RicardoScarvalho/-Robota-Segue-Linha/Barry/pcb-seguidor-2024-alison/README.md

# pcb-seguidor-2024
Desenvolvimento da pcb do robô seguidor de linha 2024 usando kicad
