RicardoScarvalho/-Robota-Segue-Linha/Sally/lista de componentes.xlsx

N° | Compoentens | Descrição | Quantidade | Link | Preço | Frete
2 | Ponte H | TB6612FNG | 1 | TB6612FNG (https://www.aliexpress.com/item/1005008526016974.html?src=google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) | 28.51 | 0
3 | Motor | Coreless eixo duplo 18000rpm | 1 | Link do motor (https://pt.aliexpress.com/item/1005001977190908.html?src=google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) | 35.69 | 0
4 | Bateria | Darwin FPV 3 Cells 60c 380mAh | 2 | https://pt.aliexpress.com/item/1005006702761223.html
5 | Sensor lateral | 10 sensores QRE1113 | 2 | link sensores (https://pt.aliexpress.com/item/1005005562914257.html?src=google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) | 18.2 | 0
6 | Mux | CD74HC4067M CI | 1 | link mux (https://www.mercadolivre.com.br/ci-hc4067--74hc4067-m--smd/up/MLBU3162970750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) | 18.57 | 7.99
8 | Buzzer | Buzzer HXD | 1 | https://www.eletrogate.com/buzzer-ativo-12v
9 | Botões | Botões: push button | 4 | https://www.eletrogate.com/push-button-chave-tactil-6x6x6mm
10 | Leds | LED 1206 3216 | 6 | https://www.acheicomponentes.com.br/led/kit-10-pecas-led-smd-amarelo-1206-3216-17-21w1d-apqhy3t
11 | Tripot | Tripot BC547 | 2 | https://www.eletrogate.com/transistor-npn-bc547
12 | Ampop | Opamp lm741 | 2 | https://www.makerhero.com/produto/lm741-ci-amplificador-operacional/
13 | Capacitor | 100nF | 2 | https://www.eletrogate.com/capacitor-poliester-metalizado-100nf-x-400v
14 | Capacitor polarizado | 47uF | 1 | https://www.eletrogate.com/capacitor-eletrolitico-47uf-x-50v
15 | ESD | TPD4E02B04DQA | 1 | https://pt.aliexpress.com/item/1005006614319754.html?gatewayAdapt=glo2bra
16 | USB Type C | USB_C_Receptacle_USB2.0_16P | 1 | https://www.proesi.com.br/conector-usb-c-femea-90-smd-16-pinos-11x7mm
17 | Resitor | 1M ohm (substituível por 100k ohm) | 1 | https://www.eletrogate.com/resistor-1m-1-4w-10-unidades?gad_source=1&gad_campaignid=20223015315
18 | Resitor | 15 ohm | 4 | https://www.proesi.com.br/resistor-carbono-cr25-1-4w-15r
19 | Resitor | 10k ohm | 10 | https://www.eletrogate.com/resistor-10k-1-4w-10-unidades?gad_source=1&gad_campaignid=20223015315
22 | Resitor | 220 ohm | 7 | https://www.eletrogate.com/resistor-220r-1-4w-10-unidades?gad_source=1&gad_campaignid=20223015315
23 | Resitor | 5k1 ohm | 2 | https://www.eletrogate.com/resistor-5k1-1-4w-10-unidades?gad_source=1&gad_campaignid=20223015315
24 | Resitor | 22 ohm | 2 | https://www.eletrogate.com/resistor-22r-1-4w-10-unidades?gad_source=1&gad_campaignid=20223015315
25 | Cabo | Cabo Flat de 8 vias | 1 | https://produto.mercadolivre.com.br/MLB-4589422190-cabo-flat-flex-8-vias-8-95-10-11-12-15-20-25-30-42cm-_JM
 | Cabo | Cabo Flat de 4 vias | 1
26 | Sensor frontal | Módulo Seguidor de Linha Infravermelho - 8 Canais | 1 | https://www.eletrogate.com/modulo-seguidor-de-linha-infravermelho-8-canais
