RicardoScarvalho/-Robota-Segue-Linha/Sally/3D/Montagem1.SLDASM

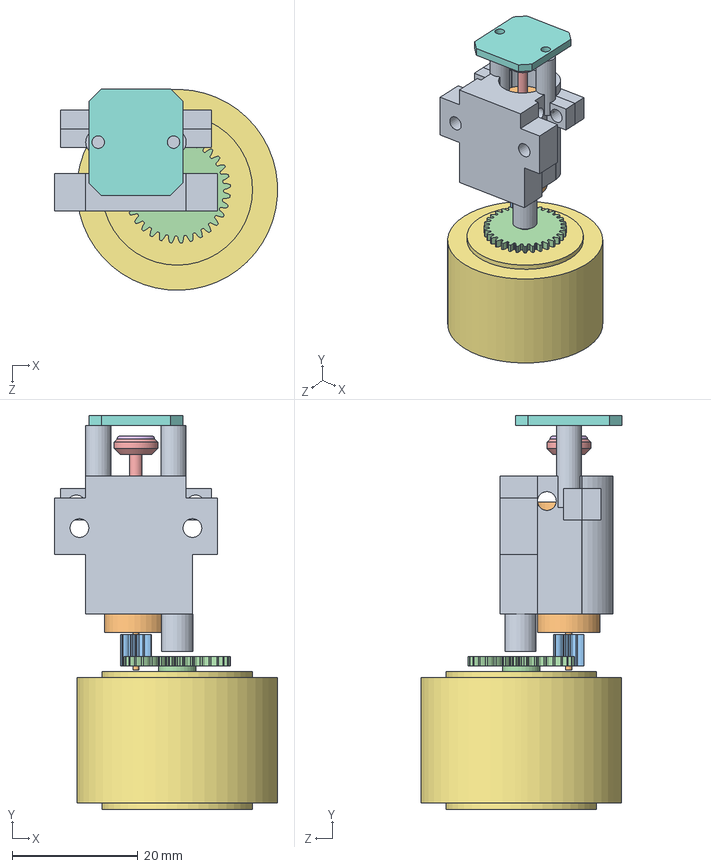
[picture p4: CAD file, 2026-09-08]
Sally/3D/Montagem1.SLDASM
35.6 x 62.8 x 32.1 mm
suporte2
motor
Engrenagem 0.5 8T-
Engrenagem 0.5 32T
suporteima
ima
roda
encoder
suporte4
