RicardoScarvalho/-Robota-Segue-Linha/Sally/3D/Montagem2.SLDASM

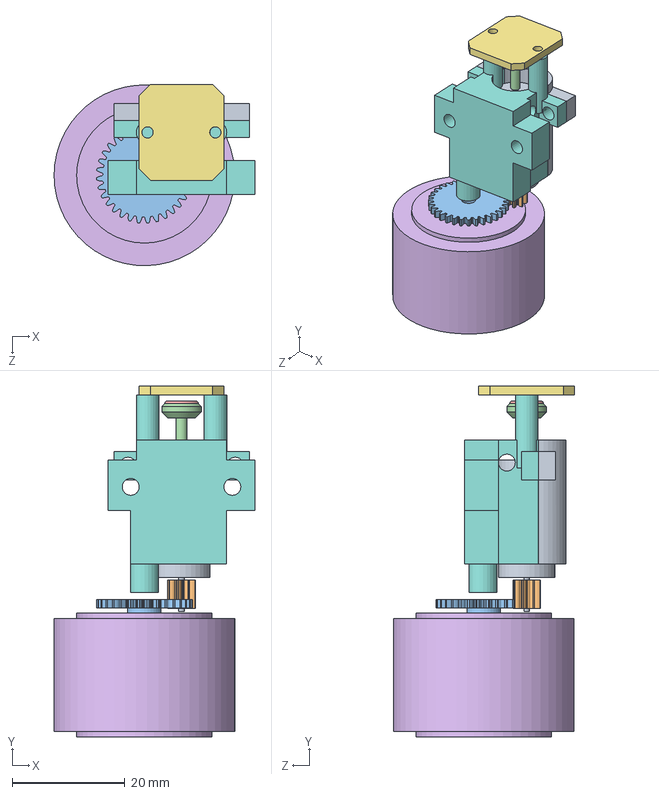
[picture p5: CAD file, 2026-09-08]
Sally/3D/Montagem2.SLDASM
35.6 x 62.2 x 32.1 mm
motor
Engrenagem 0.5 8T-
Engrenagem 0.5 32T
suporteima
ima
roda
encoder
suporte3
suporte4
