RicardoScarvalho/-Robota-Segue-Linha/Sally/3D/Montagem13.SLDASM

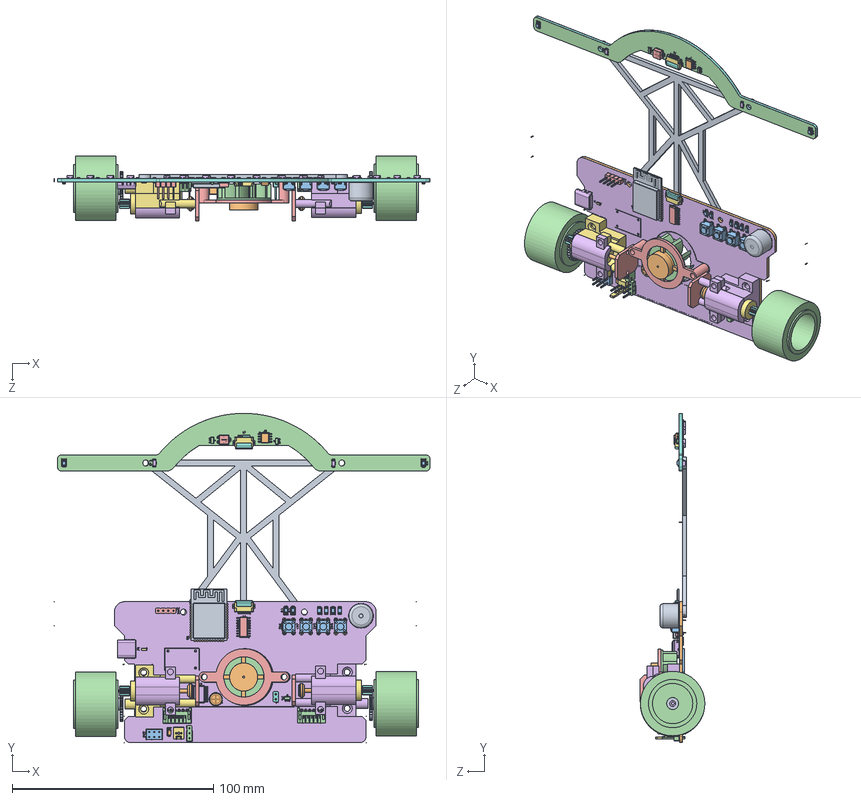
[picture p6: CAD file, 2026-09-08]
Sally/3D/Montagem13.SLDASM
186.8 x 163.6 x 32.1 mm
suporte
suportemotor - Part 2
suportesaia
ventoinha10pas
Peça97
R_1206_3216Metric x 45
lock x 2
pins x 2
SOIC-8_3.9x4.9mm_P1.27mm
LED_1206_3216Metric x 8
SOT-23 x 3
Potentiometer_Bourns_3314G_Vertical
OnSemi_CASE100CY x 16
sensor_frontal_copper
sensor_frontal_pad
sensor_frontal_via
sensor_frontal_silkscreen
sensor_frontal_silkscreen_2
sensor_frontal_soldermask
sensor_frontal_soldermask_2
sensor_frontal_PCB_1
sensor_frontal_PCB_2
sensor_frontal_PCB_3
ESP32-S3-WROOM-1
D_SOD-123
SW_PUSH_6mm x 4
PinHeader_1x03_P254mm_Vertical
SOIC-16_3.9x9.9mm_P1.27mm
SSOP-24_5.3x8.2mm_P0.65mm
USON_10_25x10mm_Pitch05mm
PinHeader_1x02_P254mm_Vertical
Buzzer_12x95RM76
CP_Radial_D63mm_P250mm
PinHeader_2x03_P254mm_Vertical
JST_S6B_PH_K x 2
PinHeader_1x04_P254mm_Vertical
USB_C_Receptacle_GCT_USB4085
Molex_AE_6410_02A
C_0805_2012Metric x 2
sally_copper
sally_pad
sally_via
sally_silkscreen
sally_silkscreen_2
sally_soldermask
sally_soldermask_2
sally_PCB_1
sally_PCB_2
sally_PCB_3
sally_PCB_4
sally_PCB_5
sally_PCB_6
sally_PCB_7
sally_PCB_8
sally_PCB_9
sally_PCB_10
sally_PCB_11
sally_PCB_12
sally_PCB_13
sally_PCB_14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
