RicardoScarvalho/-Robota-Segue-Linha/Sally/3D/Sistema de Sucção/suportemotor - Part 2.step

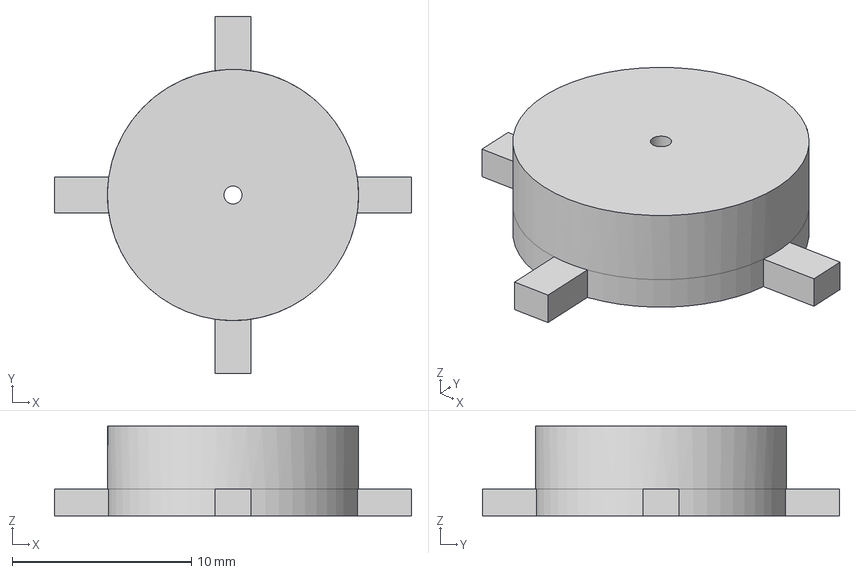
[picture p7: CAD file, 2026-09-08]
Sally/3D/Sistema de Sucção/suportemotor - Part 2.step
19.9 x 19.9 x 5.00 mm
