RicardoScarvalho/-Robota-Segue-Linha/Sally/3D/Sistema de Sucção/suportemotor.stl

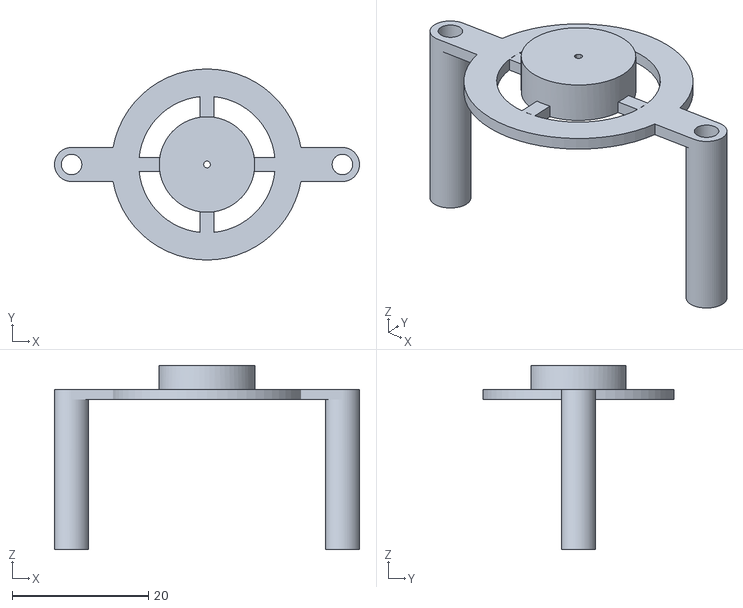
[picture p8: CAD file, 2026-09-08]
Sally/3D/Sistema de Sucção/suportemotor.stl
44.7 x 28.0 x 27.0
