RicardoScarvalho/-Robota-Segue-Linha/Sally/3D/Sistema de Sucção/Peça2.DXF

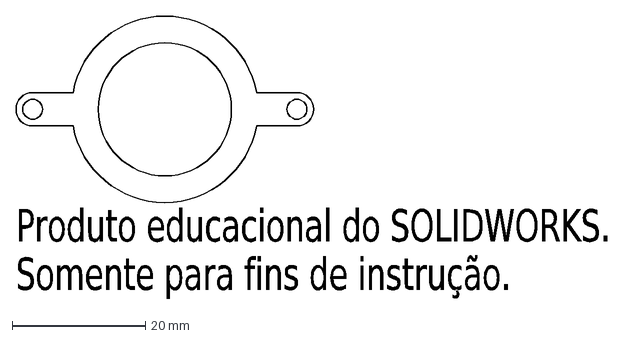
[picture p9: CAD file, 2026-09-08]
Sally/3D/Sistema de Sucção/Peça2.DXF
Produto educacional do SOLIDWORKS.
Somente para fins de instrução.
