RicardoScarvalho/-Robota-Segue-Linha/Sally/3D/Sistema de Sucção/Peça97.SLDPRT

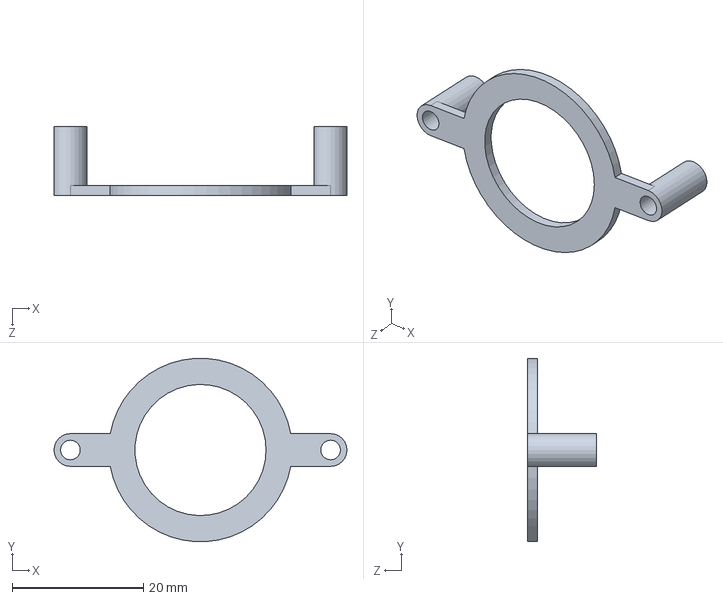
[picture p10: CAD file, 2026-09-08]
Sally/3D/Sistema de Sucção/Peça97.SLDPRT
44.7 x 27.9 x 10.5 mm
