RicardoScarvalho/-Robota-Segue-Linha/Sally/3D/ima.SLDPRT

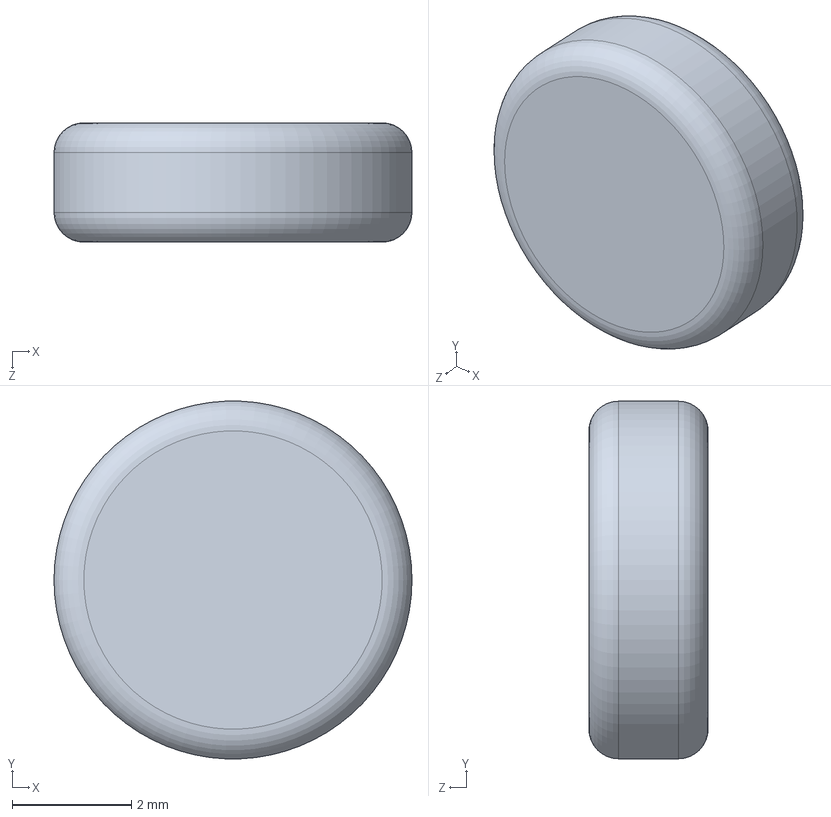
[picture p11: CAD file, 2026-09-08]
Sally/3D/ima.SLDPRT
6.00 x 5.99 x 2.00 mm
