RicardoScarvalho/-Robota-Segue-Linha/Sally/3D/Sistema de Sucção/suportemotor - Part 1.sldprt

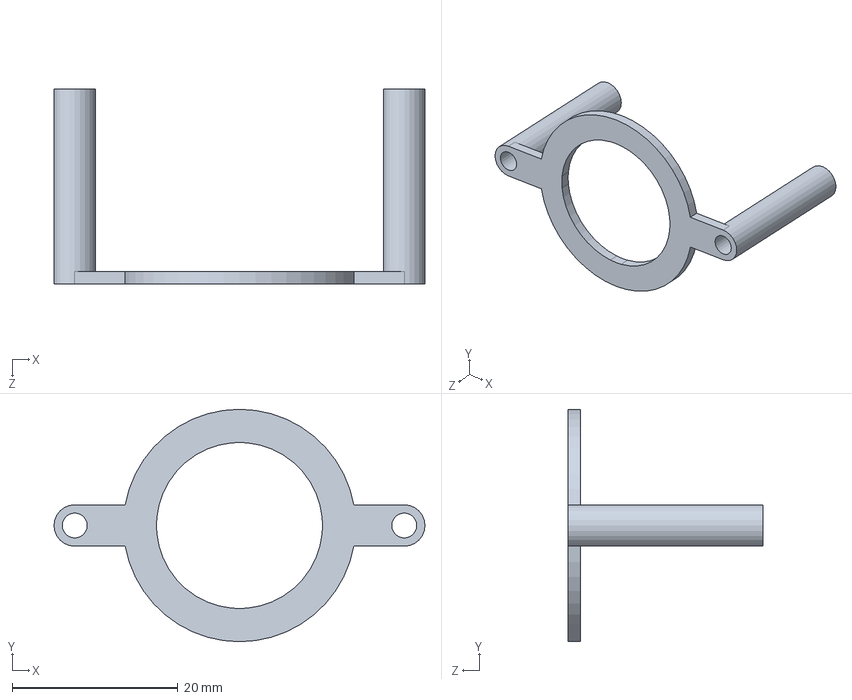
[picture p12: CAD file, 2026-09-08]
Sally/3D/Sistema de Sucção/suportemotor - Part 1.sldprt
44.7 x 28.0 x 23.5 mm
