RicardoScarvalho/-Robota-Segue-Linha/Sally/3D/Sistema de Sucção/ventoinha10pas.step

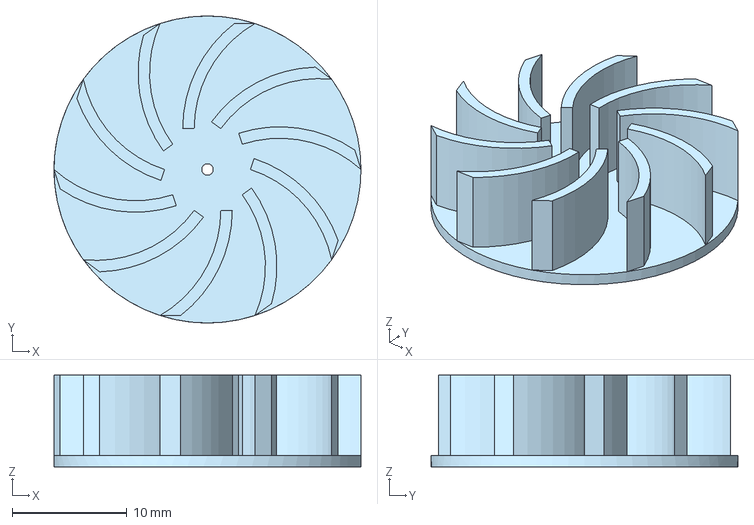
[picture p13: CAD file, 2026-09-08]
Sally/3D/Sistema de Sucção/ventoinha10pas.step
26.7 x 26.7 x 8.00 mm
