RicardoScarvalho/-Robota-Segue-Linha/Sally/3D/suporte4.SLDPRT

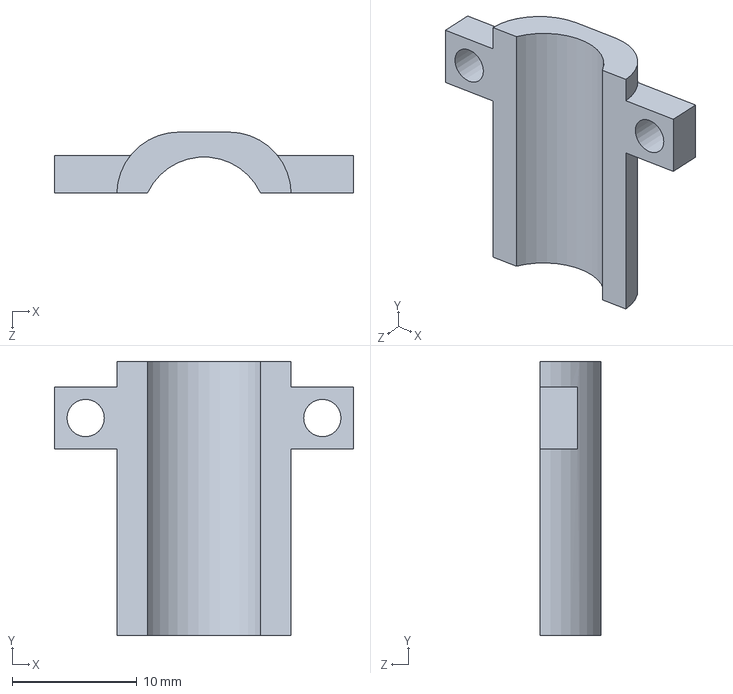
[picture p14: CAD file, 2026-09-08]
Sally/3D/suporte4.SLDPRT
24.0 x 22.0 x 4.88 mm
