RicardoScarvalho/-Robota-Segue-Linha/Sally/3D/Sistema de Sucção/suportesaia.step

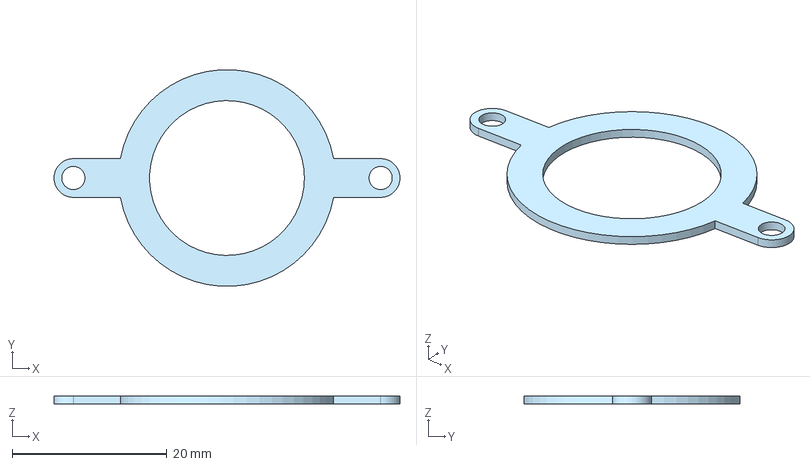
[picture p15: CAD file, 2026-09-08]
Sally/3D/Sistema de Sucção/suportesaia.step
44.7 x 27.9 x 1.00 mm
