RicardoScarvalho/-Robota-Segue-Linha/Sally/3D/Engrenagem 0.5 32T.SLDPRT

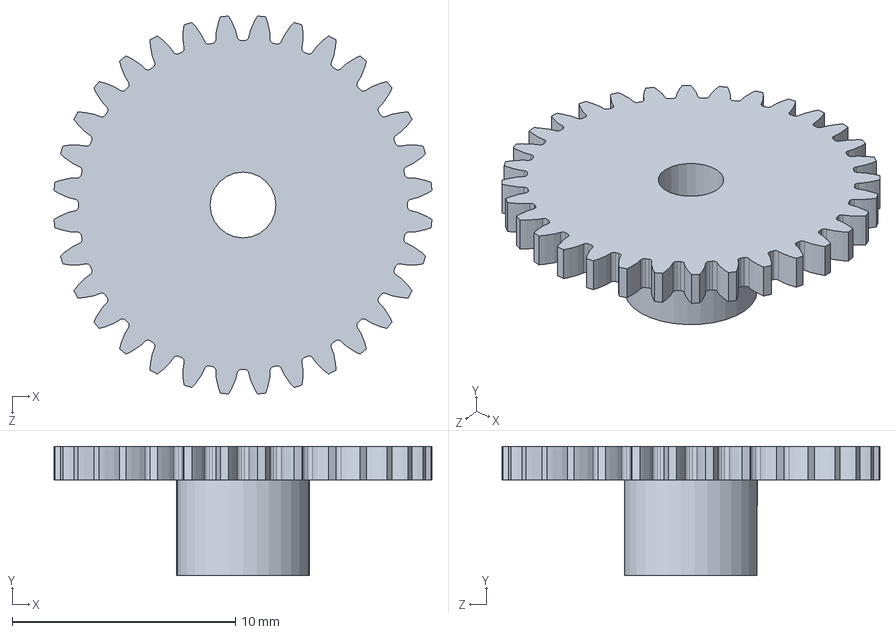
[picture p16: CAD file, 2026-09-08]
Sally/3D/Engrenagem 0.5 32T.SLDPRT
17.0 x 5.80 x 17.0 mm
