RicardoScarvalho/-Robota-Segue-Linha/Sally/3D/Engrenagem 0.5 8T-.SLDPRT

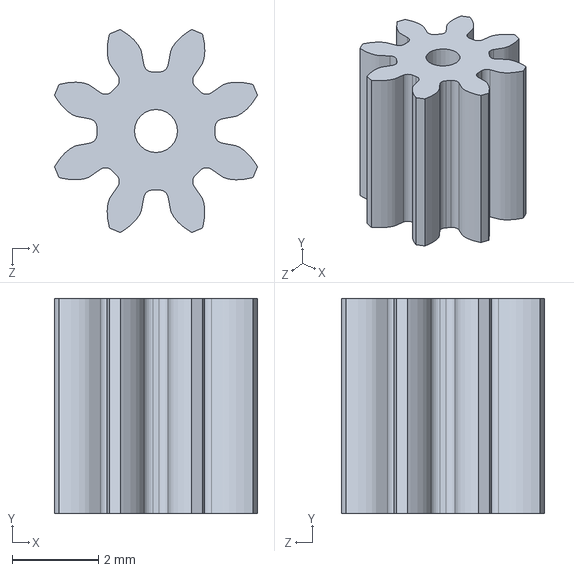
[picture p17: CAD file, 2026-09-08]
Sally/3D/Engrenagem 0.5 8T-.SLDPRT
4.72 x 5.00 x 4.72 mm
