RicardoScarvalho/-Robota-Segue-Linha/Sally/3D/suporte2.SLDPRT

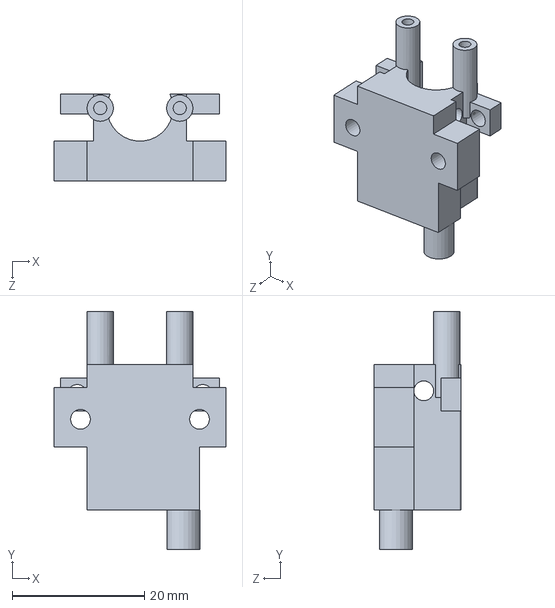
[picture p18: CAD file, 2026-09-08]
Sally/3D/suporte2.SLDPRT
26.0 x 36.0 x 13.1 mm
