RicardoScarvalho/-Robota-Segue-Linha/Sally/3D/encoder.SLDPRT

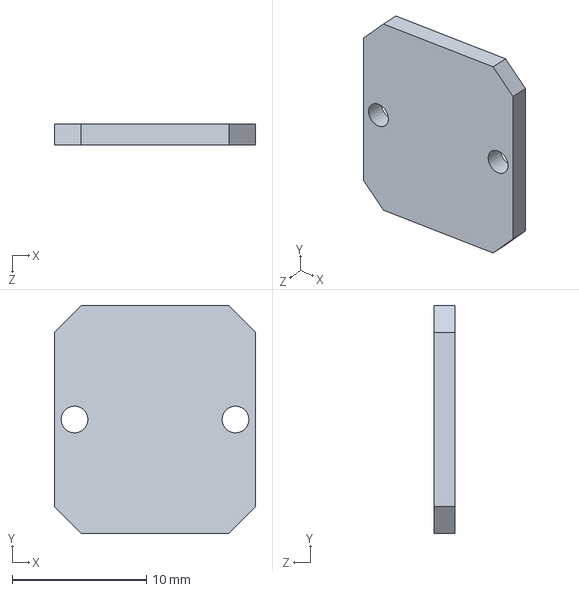
[picture p19: CAD file, 2026-09-08]
Sally/3D/encoder.SLDPRT
15.0 x 17.0 x 1.60 mm
