RicardoScarvalho/-Robota-Segue-Linha/Sally/3D/roda.SLDPRT

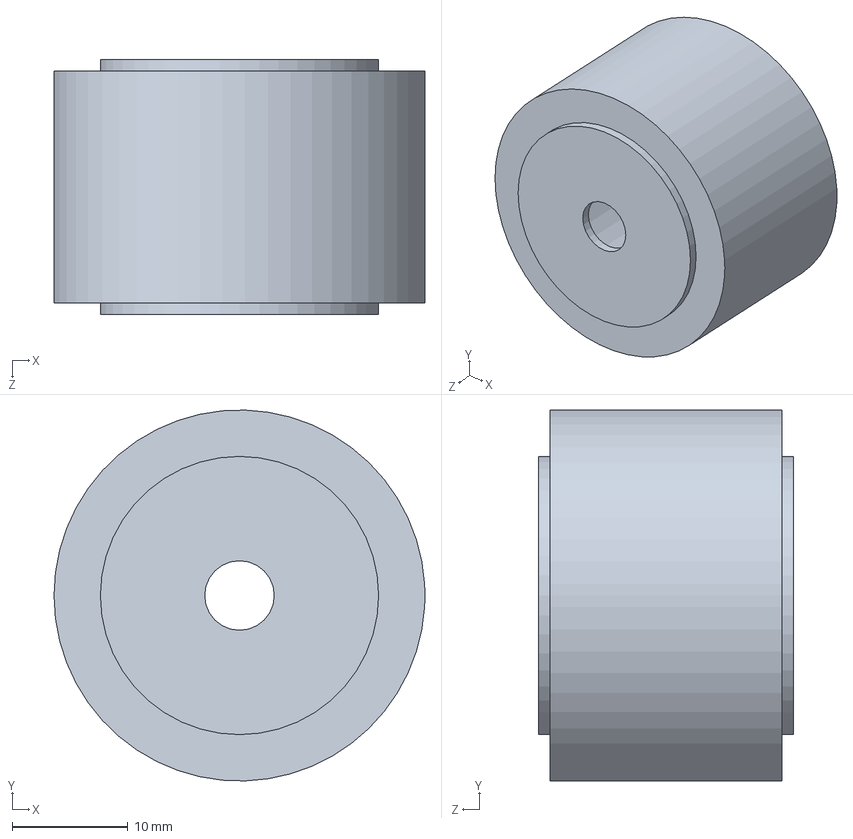
[picture p20: CAD file, 2026-09-08]
Sally/3D/roda.SLDPRT
32.0 x 32.0 x 22.0 mm
