RicardoScarvalho/-Robota-Segue-Linha/Sally/3D/suporte3.SLDPRT

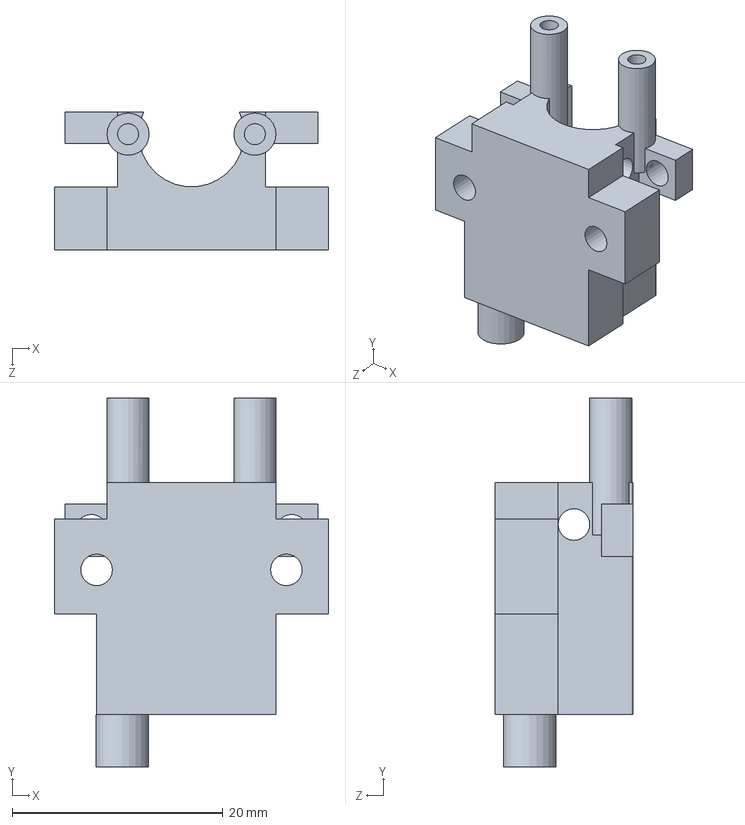
[picture p21: CAD file, 2026-09-08]
Sally/3D/suporte3.SLDPRT
26.0 x 35.0 x 13.1 mm
