RicardoScarvalho/-Robota-Segue-Linha/Sally/3D/Sensor Frontal/Sensor.step

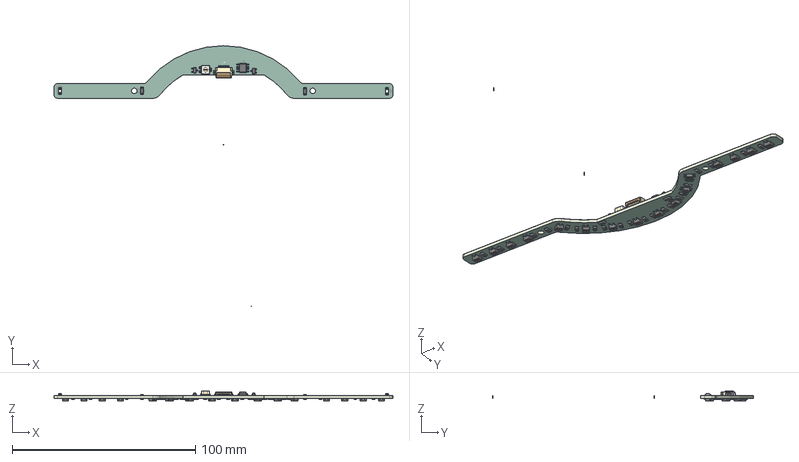
[picture p22: CAD file, 2026-09-08]
Sally/3D/Sensor Frontal/Sensor.step
185.0 x 142.2 x 5.65 mm
R_1206_3216Metric x 26
lock
pins
SOIC-8_3.9x4.9mm_P1.27mm
LED_1206_3216Metric x 2
SOT-23 x 2
Potentiometer_Bourns_3314G_Vertical
OnSemi_CASE100CY x 16
sensor_frontal_copper
sensor_frontal_pad
sensor_frontal_via
sensor_frontal_silkscreen x 2
sensor_frontal_soldermask x 2
sensor_frontal_PCB_1
sensor_frontal_PCB_2
sensor_frontal_PCB_3
