RicardoScarvalho/-Robota-Segue-Linha/Sally/3D/suporteima.SLDPRT

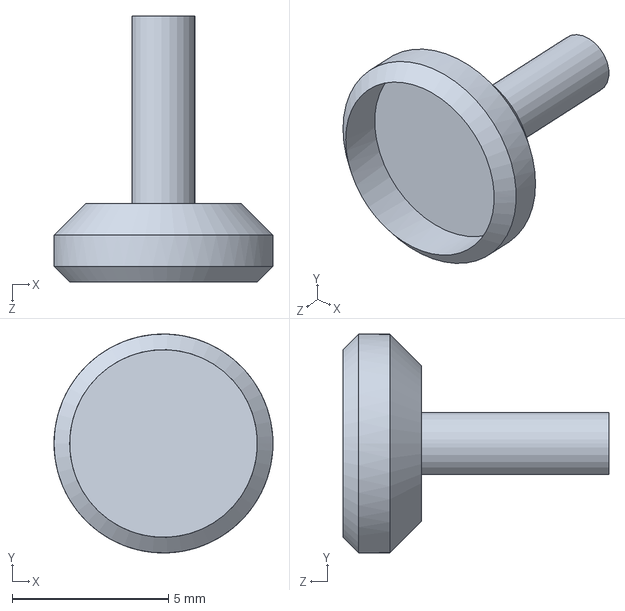
[picture p23: CAD file, 2026-09-08]
Sally/3D/suporteima.SLDPRT
7.00 x 7.00 x 8.50 mm
