RicardoScarvalho/-Robota-Segue-Linha/Sally/3D/suporte.SLDPRT

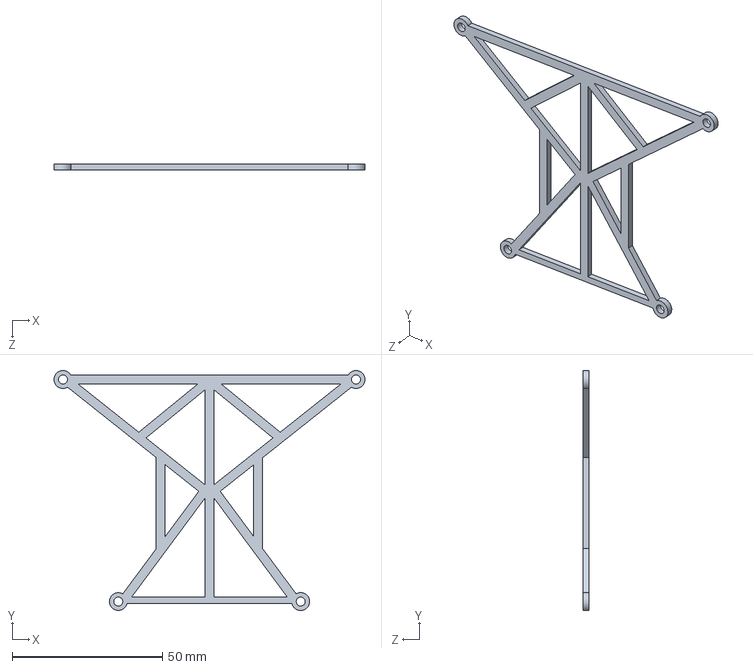
[picture p24: CAD file, 2026-09-08]
Sally/3D/suporte.SLDPRT
103.5 x 79.9 x 2.00 mm
