RicardoScarvalho/-Robota-Segue-Linha/Sally/3D/motor.SLDPRT

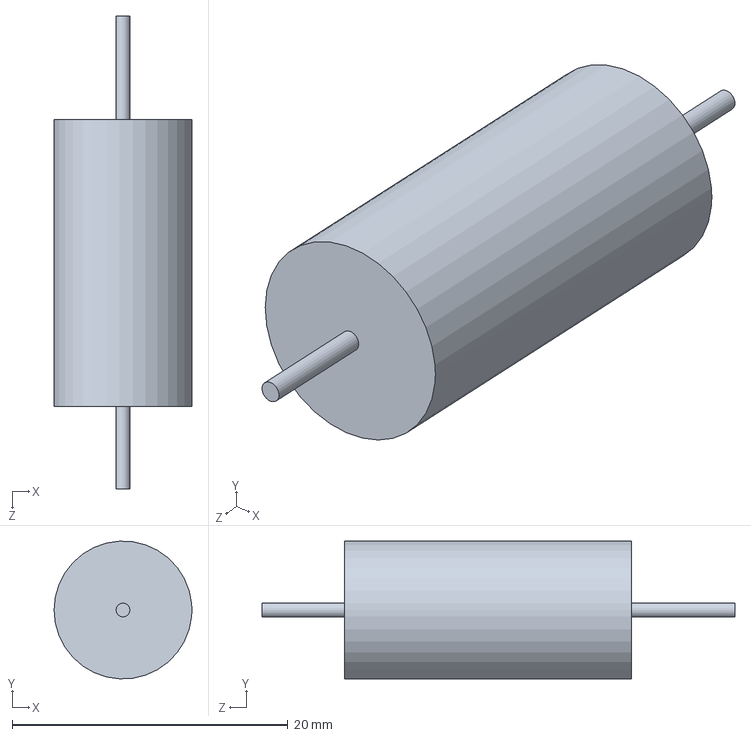
[picture p25: CAD file, 2026-09-08]
Sally/3D/motor.SLDPRT
10.0 x 9.99 x 34.3 mm
