RicardoScarvalho/-Robota-Segue-Linha/Sally/3D/bateria.stl

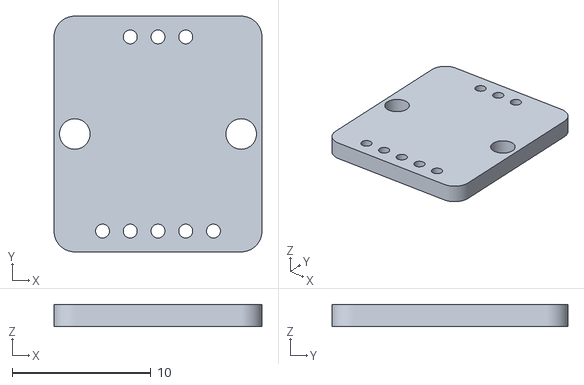
[picture p26: CAD file, 2026-09-08]
Sally/3D/bateria.stl
15.0 x 17.0 x 1.60
