RicardoScarvalho/-Robota-Segue-Linha/Sally/3D/suportemotor.SLDPRT

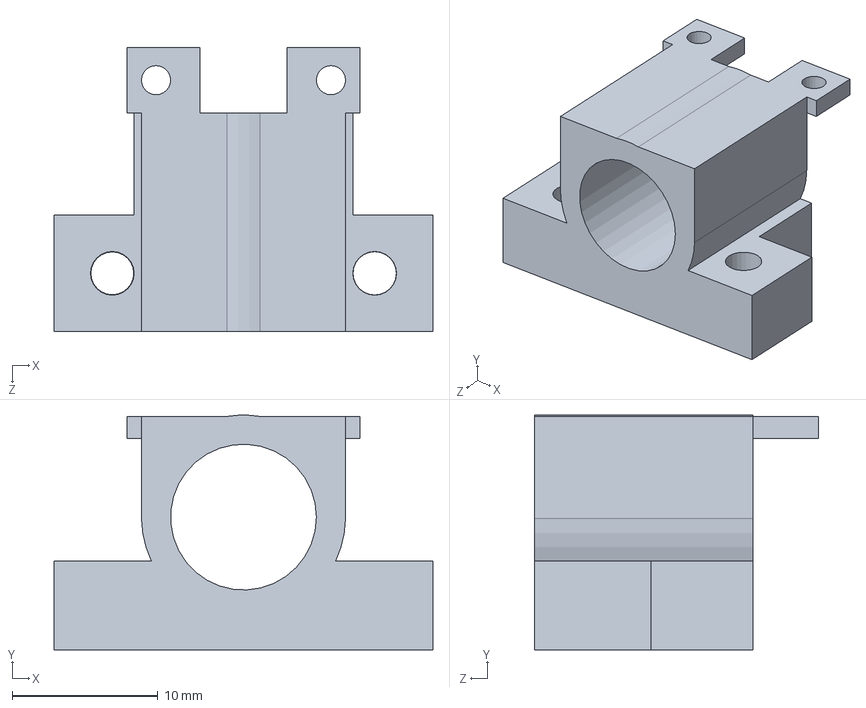
[picture p27: CAD file, 2026-09-08]
Sally/3D/suportemotor.SLDPRT
26.0 x 16.1 x 19.5 mm
