RicardoScarvalho/-Robota-Segue-Linha/(list of files, cad)

Other CAD files:
Sally/3D/Sensor Frontal/OnSemi_CASE100CY.sldasm
Sally/3D/Sensor Frontal/LED_1206_3216Metric.sldasm
Sally/3D/PCB/PinHeader_1x04_P2.54mm_Vertical.sldasm
Sally/3D/PCB/CP_Radial_D6.3mm_P2.50mm.sldasm
Sally/3D/Sensor Frontal/R_1206_3216Metric.sldasm
Sally/3D/PCB/D_SOD-123.sldasm
Sally/3D/Sensor Frontal/Hirose_FH12_xxS_0_5SH_Parametric_v0_1.sldasm
Sally/3D/Sensor Frontal/SOIC-8_3.9x4.9mm_P1.27mm.sldasm
Sally/3D/PCB/SW_PUSH_6mm.sldasm
Sally/3D/Sensor Frontal/Potentiometer_Bourns_3314G_Vertical.sldasm
Sally/3D/PCB/Hirose_FH12_xxS_0_5SH_Parametric_v0_1.sldasm
Sally/3D/Sensor Frontal/Hirose_FH12-12S-0.5SH_1x12-1MP_P0.50mm_Horizontal.sldasm
Sally/3D/PCB/SOIC-16_3.9x9.9mm_P1.27mm.sldasm
Sally/3D/PCB/USON-10_2.5x1.0mm_P0.5mm.sldasm
Sally/3D/Sensor Frontal/SOT-23.sldasm
Sally/3D/PCB/Buzzer_12x9.5RM7.6.sldasm
Sally/3D/PCB/ESP32-S3-WROOM-1.sldasm
Sally/3D/PCB/LED_1206_3216Metric.sldasm
Sally/3D/PCB/USB_C_Receptacle_GCT_USB4085.sldasm
Sally/3D/PCB/PinHeader_1x03_P2.54mm_Vertical.sldasm
Sally/3D/PCB/SSOP-24_5.3x8.2mm_P0.65mm.sldasm
Sally/3D/PCB/SOT-23.sldasm
Sally/3D/PCB/JST_PH_S6B-PH-K_1x06_P2.00mm_Horizontal.sldasm
Sally/3D/PCB/R_1206_3216Metric.sldasm
Sally/3D/PCB/Hirose_FH12-12S-0.5SH_1x12-1MP_P0.50mm_Horizontal.sldasm
Sally/3D/PCB/PinHeader_1x02_P2.54mm_Vertical.sldasm
Sally/3D/PCB/C_0805_2012Metric.sldasm
Sally/3D/PCB/Molex_KK-254_AE-6410-02A_1x02_P2.54mm_Vertical.sldasm
Sally/3D/PCB/PinHeader_2x03_P2.54mm_Vertical.sldasm
Sally/3D/PCB/sally_silkscreen_2.sldprt
Sally/3D/Sensor Frontal/sensor_frontal_pad.sldprt
Sally/3D/sensor_frontal_pad.sldprt
Sally/3D/suporte/sensorfrontal.SLDPRT
Sally/estrutura/sensorfrontal.SLDPRT
Sally/3D/PCB/sally_PCB_11.sldprt
Sally/3D/sensor_frontal_silkscreen_2.sldprt
Sally/3D/suporte/formatopcb.SLDPRT
Sally/estrutura/formatopcb.SLDPRT
Sally/3D/PCB/PinHeader_2x03_P254mm_Vertical.sldprt
Sally/3D/sensor_frontal_copper.sldprt
Sally/3D/Sensor Frontal/sensor_frontal_PCB_2.sldprt
Sally/3D/sensor_frontal_PCB_2.sldprt
Sally/3D/PCB/sally_PCB_6.sldprt
Sally/3D/Sensor Frontal/sensor_frontal_PCB_3.sldprt
Sally/3D/PCB/PCB.step
Sally/3D/Sensor Frontal/sensor_frontal_via.sldprt
Sally/3D/lock_1.sldprt
Sally/3D/Sensor Frontal/sensor_frontal_silkscreen.sldprt
Sally/3D/PCB/sally_pad.sldprt
Sally/3D/Sensor Frontal/lock.sldprt
Sally/3D/PCB/Buzzer_12x95RM76.sldprt
Sally/3D/SOT-23_1.sldprt
Sally/3D/PCB/PinHeader_1x03_P254mm_Vertical.sldprt
Sally/3D/Sensor Frontal/sensor_frontal_soldermask_2.sldprt
Sally/3D/sensor_frontal_silkscreen.sldprt
Sally/3D/body_1.sldprt
Sally/3D/PCB/sally_PCB_13.sldprt
Sally/3D/PCB/sally_via.sldprt
Sally/3D/Sensor Frontal/sensor_frontal_silkscreen_2.sldprt
Sally/3D/Sensor Frontal/sensor_frontal_copper.sldprt
Sally/3D/PCB/sally_PCB_2.sldprt
Sally/3D/OnSemi_CASE100CY.sldprt
Sally/3D/Sensor Frontal/sensor_frontal_soldermask.sldprt
Sally/3D/PCB/CP_Radial_D63mm_P250mm.sldprt
Sally/3D/Sensor Frontal/sensor_frontal_PCB_1.sldprt
Sally/3D/LED_1206_3216Metric_1.sldprt
Sally/3D/Sensor Frontal/pins.sldprt
Sally/3D/PCB/sally_PCB_7.sldprt
Sally/3D/R_1206_3216Metric_1.sldprt
Sally/3D/Sensor Frontal/body.sldprt
Sally/3D/PCB/USON_10_25x10mm_Pitch05mm.sldprt
Sally/3D/PCB/sally_PCB_12.sldprt
Sally/3D/Potentiometer_Bourns_3314G_Vertical.sldprt
Sally/3D/PCB/sally_silkscreen.sldprt
Sally/3D/sensor_frontal_via.sldprt
Sally/3D/PCB/sally_PCB_4.sldprt
Sally/3D/PCB/sally_PCB_1.sldprt
Sally/3D/PCB/body.sldprt
Sally/3D/PCB/PinHeader_1x02_P254mm_Vertical.sldprt
Sally/3D/SOIC-8_3.9x4.9mm_P1.27mm.sldprt
Sally/3D/PCB/sally_soldermask_2.sldprt
Sally/3D/PCB/sally_PCB_10.sldprt
Sally/3D/sensor_frontal_PCB_1.sldprt
Sally/3D/pins_1.sldprt
Sally/3D/PCB/pins.sldprt
Sally/3D/PCB/sally_PCB_3.sldprt
Sally/3D/PCB/sally_soldermask.sldprt
Sally/3D/PCB/sally_PCB_8.sldprt
Sally/3D/PCB/PinHeader_1x04_P254mm_Vertical.sldprt
Sally/3D/PCB/sally_PCB_9.sldprt
Sally/3D/PCB/sally_PCB_14.sldprt
Sally/3D/PCB/lock.sldprt
Sally/3D/PCB/sally_PCB_5.sldprt
Sally/3D/PCB/Molex_AE_6410_02A.sldprt
Sally/3D/PCB/sally_copper.sldprt
Sally/3D/PCB/JST_S6B_PH_K.sldprt
Sally/3D/Montagem13.SLDDRW
Sally/3D/PCB/C_0805_2012Metric.sldprt
Sally/3D/PCB/D_SOD-123.sldprt
Sally/3D/PCB/ESP32-S3-WROOM-1.sldprt
Sally/3D/PCB/LED_1206_3216Metric.sldprt
Sally/3D/PCB/PCB.SLDASM
Sally/3D/PCB/R_1206_3216Metric.sldprt
Sally/3D/PCB/SOIC-16_3.9x9.9mm_P1.27mm.sldprt
Sally/3D/PCB/SOT-23.sldprt
Sally/3D/PCB/SSOP-24_5.3x8.2mm_P0.65mm.sldprt
Sally/3D/PCB/SW_PUSH_6mm.sldprt
Sally/3D/PCB/USB_C_Receptacle_GCT_USB4085.sldprt
Sally/3D/Sensor Frontal/LED_1206_3216Metric.sldprt
Sally/3D/Sensor Frontal/OnSemi_CASE100CY.sldprt
Sally/3D/Sensor Frontal/Potentiometer_Bourns_3314G_Vertical.sldprt
Sally/3D/Sensor Frontal/R_1206_3216Metric.sldprt
Sally/3D/Sensor Frontal/SOIC-8_3.9x4.9mm_P1.27mm.sldprt
Sally/3D/Sensor Frontal/SOT-23.sldprt
Sally/3D/Sensor Frontal/Sensor.SLDASM
Sally/3D/Sistema de Sucção/suportemotor - Part 2.SLDPRT
Sally/3D/Sistema de Sucção/suportesaia.SLDPRT
Sally/3D/Sistema de Sucção/suportesaia.stl
Sally/3D/Sistema de Sucção/ventoinha10pas.SLDPRT
Sally/3D/Sistema de Sucção/ventoinha10pas.stl
Sally/3D/suporte/formatopcb.DXF
Sally/3D/suporte/sensorfrontal.DXF
Sally/3D/suporte2.STL
Sally/3D/suporte3.STL
Sally/3D/suporte4.STL
Sally/estrutura/formatopcb.DXF
Sally/estrutura/sensorfrontal.DXF
