RicardoScarvalho/-Robota-Segue-Linha/Sally/PCB/sally/sally.kicad_pcb

## KiCad design Sally/PCB/sally/sally.kicad_pcb (2026-09-08)

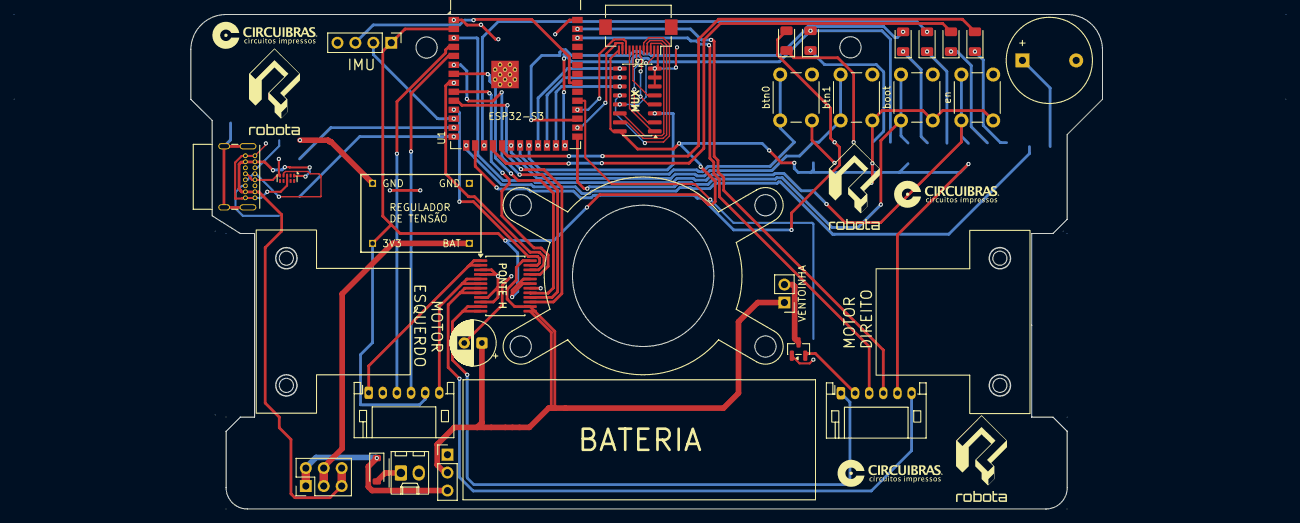
[picture p31: board sally.kicad_pcb from above]

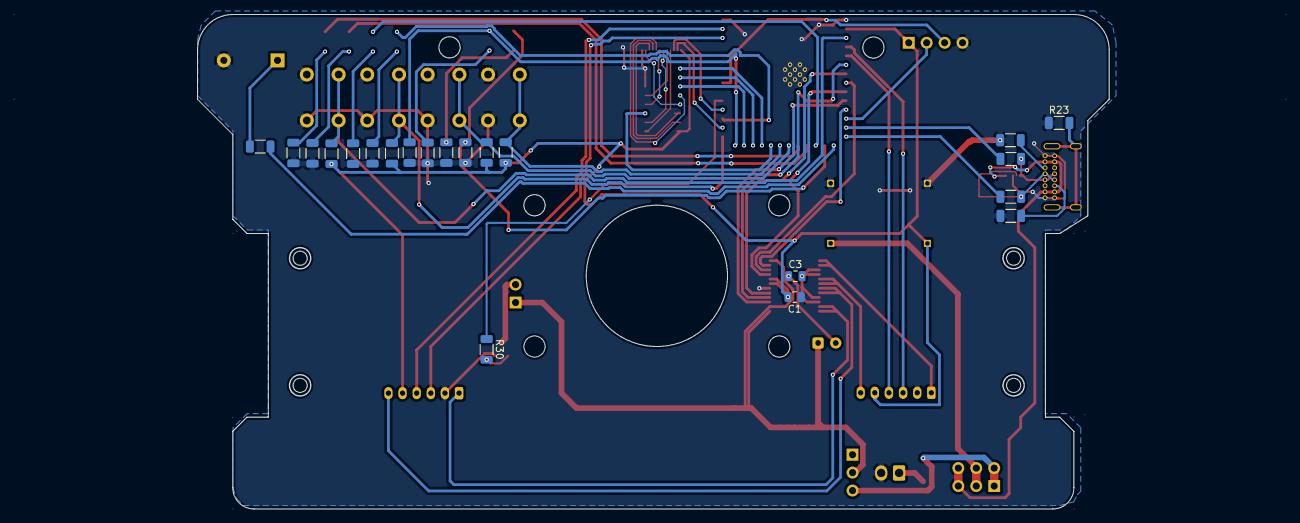
[picture p32: board sally.kicad_pcb from below]

Board: 2 copper layers, 129.1 x 70.0 mm, 51 parts (21 on the bottom side), 67 nets.

Parts:
BZ1: Buzzer; Buzzer_12x9.5RM7.6
C1, C3: 100nF; C_0805_2012Metric
C_Polarized1: 47uF; CP_Radial_D6.3mm_P2.50mm
D1: 1N4148W; D_SOD-123
D2, D3, D4, D5, D6, D7: LED; LED_1206_3216Metric
J2: Conn_02x06_Top_Bottom; Hirose_FH12-12S-0.5SH_1x12-1MP_P0.50mm_Horizontal
J3: Conn_01x03_Pin; PinHeader_1x03_P2.54mm_Vertical
J4: USB_C_Receptacle_USB2.0_16P; USB_C_Receptacle_GCT_USB4085
J5: MOTOR1; JST_PH_S6B-PH-K_1x06_P2.00mm_Horizontal
J6: MOTOR2; JST_PH_S6B-PH-K_1x06_P2.00mm_Horizontal
Q3: Q_NMOS_GSD; SOT-23
R1, R3: 22; R_1206_3216Metric
R2, R24: 5k1; R_1206_3216Metric
R4, R6, R10, R25, R26, R27, R28, R30: 220; R_1206_3216Metric
R5, R7: pull_down; R_1206_3216Metric
R8, R9, R19, R22: pull_up; R_1206_3216Metric
R23: 1M; R_1206_3216Metric
SW7: SW_DPDT_x2; PinHeader_2x03_P2.54mm_Vertical
Suporte_dos_motores_1, Suporte_dos_motores_2: suporte
U1: ESP32-S3-WROOM-1
U4: TPD4E02B04DQA; USON-10_2.5x1.0mm_P0.5mm
U5: 74HC4051; SOIC-16_3.9x9.9mm_P1.27mm
U10: TB6612FNG; SSOP-24_5.3x8.2mm_P0.65mm
VENTOINHA: Conn_01x02_Socket; PinHeader_1x02_P2.54mm_Vertical
boot: boot; SW_PUSH_6mm
btn0: btn0; SW_PUSH_6mm
btn1: btn1; SW_PUSH_6mm
con1: BATERIA; Molex_KK-254_AE-6410-02A_1x02_P2.54mm_Vertical
con6: IMU; PinHeader_1x04_P2.54mm_Vertical
en: en; SW_PUSH_6mm
stepdown1: stepdown

Connections:
+3V3: C1.2, J2.12, J5.5, J6.5, R8.1, R9.1, R19.1, R22.1, U1.2 (3V3), U5.16 (VCC), U10.19 (STBY), U10.20 (VCC), con6.1, stepdown1.3 (OUT+)
+5V: J4.A4 (VBUS), J4.A9 (VBUS), J4.B4 (VBUS), J4.B9 (VBUS), SW7.5 (C), SW7.6 (C), U4.1 (IO1)
+12V: D1.2 (A), con1.1
A01: J5.1, U10.1 (AO1), U10.2 (AO1)
A02: J5.6, U10.5 (AO2), U10.6 (AO2)
AI1: U1.9 (GPIO16/U0CTS/ADC2_CH5/XTAL_32K_N), U10.21 (AIN1)
AI2: U1.8 (GPIO15/U0RTS/ADC2_CH4/XTAL_32K_P), U10.22 (AIN2)
B01: J6.1, U10.11 (BO1), U10.12 (BO1)
B02: J6.6, U10.7 (BO2), U10.8 (BO2)
BAT: SW7.3 (B), SW7.4 (B), stepdown1.1 (IN+)
BI1: U1.7 (GPIO7/TOUCH7/ADC1_CH6), U10.17 (BIN1)
BI2: U1.6 (GPIO6/TOUCH6/ADC1_CH5), U10.16 (BIN2)
BTN0: R8.2, U1.21 (GPIO13/TOUCH13/ADC2_CH2/FSPIQ/FSPIIO7/S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), btn0.1
BTN1: R9.2, U1.20 (GPIO12/TOUCH12/ADC2_CH1/FSPICLK/FSPIIO6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), btn1.1
BZR: R10.2, U1.15 (GPIO3/TOUCH3/ADC1_CH2)
Diodo: D1.1 (K), J3.3, SW7.1 (A), SW7.2 (A)
EN: R22.2, U1.3 (EN), en.1
ENC11: J5.3, U1.4 (GPIO4/TOUCH4/ADC1_CH3)
ENC12: J5.4, U1.5 (GPIO5/TOUCH5/ADC1_CH4)
ENC21: J6.3, U1.38 (GPIO2/TOUCH2/ADC1_CH1)
ENC22: J6.4, U1.39 (GPIO1/TOUCH1/ADC1_CH0)
GND: BZ1.2 (+), C1.1, J2.1, J4.A1 (GND), J4.A12 (GND), J4.B1 (GND), J4.B12 (GND), J5.2, J6.2, Q3.2 (S), R2.2, R4.2, R5.2, R6.2, R7.2, R23.1, R24.2, R25.2, R26.2, R27.2, R28.2, U1.1 (GND), U1.40 (GND), U1.41 (GND), U4.3 (G), U4.8 (G), U5.6 (~E), U5.7 (VEE), U5.8 (GND), U10.18 (GND), boot.2, btn0.2, btn1.2, con1.2, con6.4, en.2, stepdown1.2 (IN-), stepdown1.4 (OUT-)
IO0-BOOT: R19.2, U1.27 (GPIO0/BOOT), boot.1
LED0: D4.2 (A), U1.29 (SPIIO7/GPIO36/FSPICLK/SUBSPICLK)
LED1: D5.2 (A), U1.17 (GPIO9/TOUCH9/ADC1_CH8/FSPIHD/SUBSPIHD)
LED2: D6.2 (A), U1.18 (GPIO10/TOUCH10/ADC1_CH9/FSPICS0/FSPIIO4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)
LED3: D7.2 (A), U1.19 (GPIO11/TOUCH11/ADC2_CH0/FSPID/FSPIIO5/S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)
MUX-S0: U1.25 (GPIO48/SPICLK_N/SUBSPICLK_N_DIFF), U5.11 (S0)
MUX-S1: U1.24 (GPIO47/SPICLK_P/SUBSPICLK_P_DIFF), U5.10 (S1)
MUX-S2: U1.23 (GPIO21), U5.9 (S2)
MUX-SIG: U1.22 (GPIO14/TOUCH14/ADC2_CH3/FSPIWP/FSPIDQS/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), U5.3 (A)
Mosfet: R30.1, U1.31 (GPIO38/FSPIWP/SUBSPIWP)
unnamed: BZ1.1 (-), R10.1
unnamed: C3.1, C_Polarized1.2
unnamed: C3.2, U10.3 (PGND1), U10.4 (PGND1), U10.9 (PGND2), U10.10 (PGND2)
unnamed: D2.1 (K), R4.1
unnamed: D3.1 (K), R6.1
unnamed: D4.1 (K), R25.1
unnamed: D5.1 (K), R26.1
unnamed: D6.1 (K), R27.1
unnamed: D7.1 (K), R28.1
unnamed: J2.2, U5.13 (A0)
unnamed: J2.3, U5.14 (A1)
unnamed: J2.4, U5.15 (A2)
unnamed: J2.5, U5.12 (A3)
unnamed: J2.6, U5.4 (A7)
unnamed: J2.7, U5.2 (A6)
unnamed: J2.8, U5.5 (A5)
unnamed: J2.9, U5.1 (A4)
unnamed: J4.A5 (CC1), R2.1
unnamed: J4.B5 (CC2), R24.1
unnamed: J4.SH (SHIELD), R23.2
unnamed: Q3.1 (G), R30.2
unnamed: J4.A6 (D+), J4.B6 (D+), R3.2, U4.4 (IO3)
unnamed: J4.A7 (D-), J4.B7 (D-), R1.2, U4.5 (IO4)
PWMA: U1.11 (GPIO18/U1RXD/ADC2_CH7/CLK_OUT3), U10.23 (PWMA)
PWMB: U1.10 (GPIO17/U1TXD/ADC2_CH6), U10.15 (PWMB)
SDA: U1.12 (GPIO8/TOUCH8/ADC1_CH7/SUBSPICS1), con6.2
SDL: U1.33 (MTDO/GPIO40/CLK_OUT2), con6.3
SL_digital: J2.11, U1.28 (SPIIO6/GPIO35/FSPID/SUBSPID)
SP-IO45: D3.2 (A), R7.1, U1.26 (GPIO45)
SP-IO46: D2.2 (A), R5.1, U1.16 (GPIO46)
SR_digital: J2.10, U1.30 (SPIDQS/GPIO37/FSPIQ/SUBSPIQ)
Saida: C_Polarized1.1, J3.2, U10.13 (VM2), U10.14 (VM3), U10.24 (VM1), VENTOINHA.1
USB_D+: R3.1, U1.14 (GPIO20/U1CTS/ADC2_CH9/CLK_OUT1/USB_D+)
USB_D-: R1.1, U1.13 (GPIO19/U1RTS/ADC2_CH8/CLK_OUT2/USB_D-)
Ventoinha: Q3.3 (D), VENTOINHA.2
